mka1ugin/kessy_handles_adapter/schematic.png

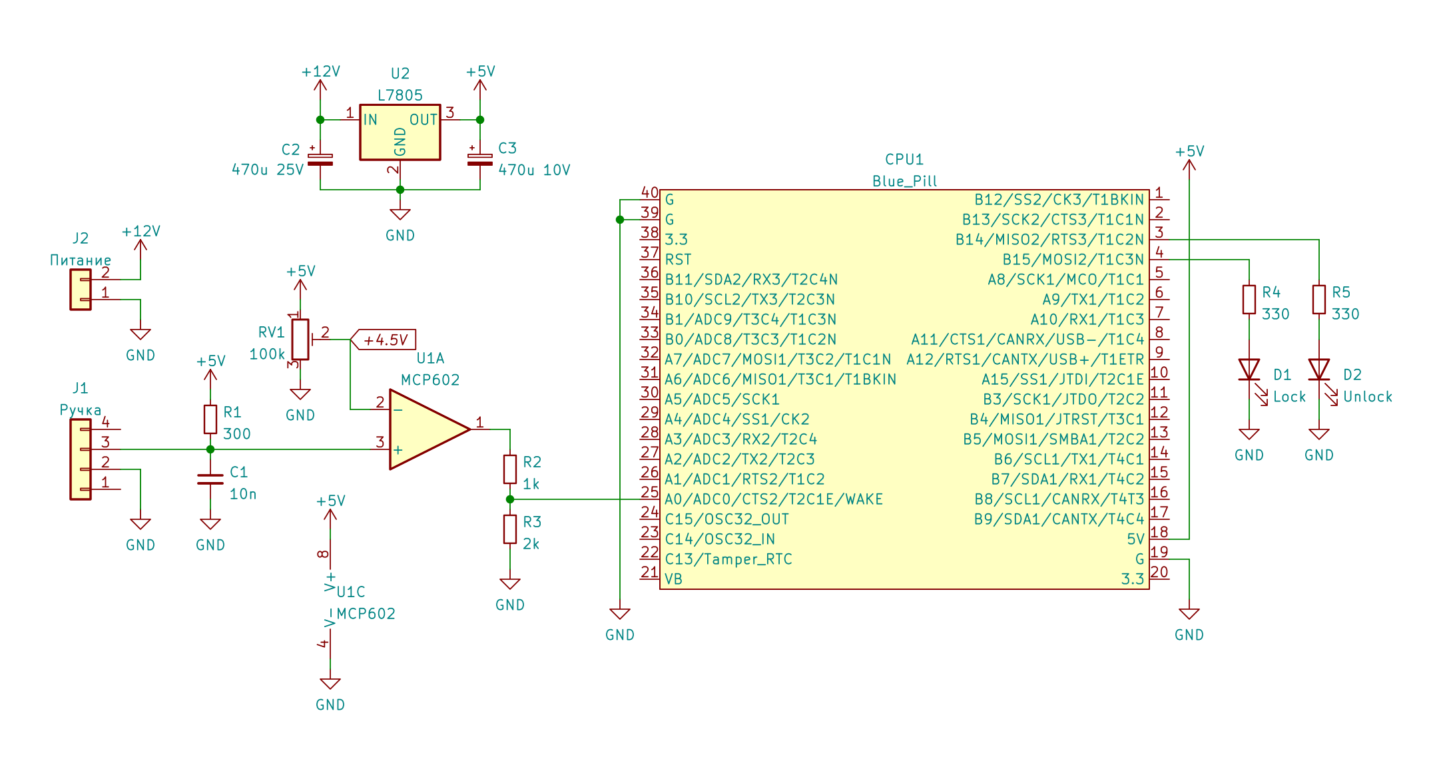
schematic.png
