mka1ugin/kessy_handles_adapter/schematic.pdf

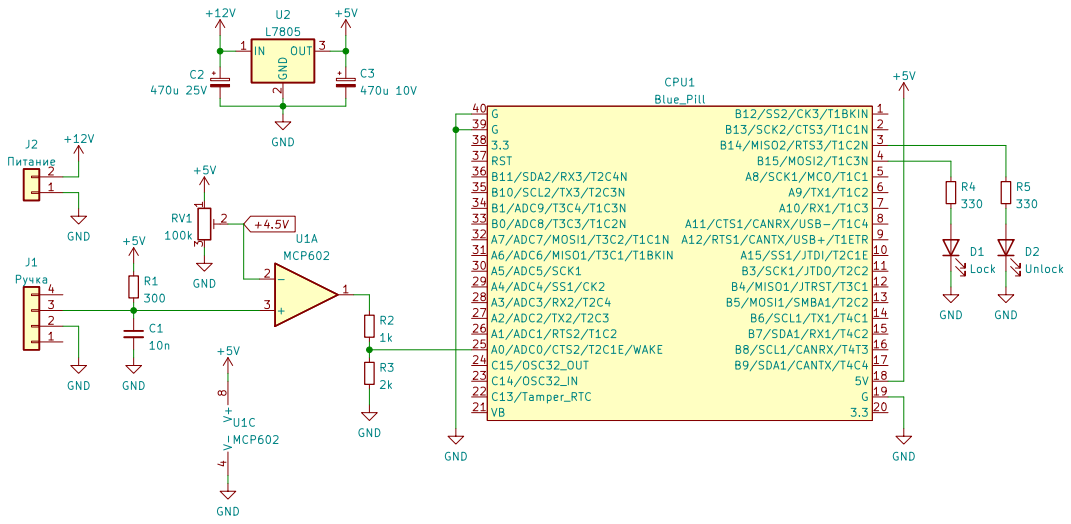
[picture p2: page 1]

File: sample.kicad_sch Sheet: / GND
