mka1ugin/kessy_handles_adapter/Core/Src/main.c

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
/* Includes ------------------------------------------------------------------*/
#include "main.h"

TIM_HandleTypeDef htim2;
TIM_HandleTypeDef htim3;

void SystemClock_Config(void);
static void MX_GPIO_Init(void);
static void MX_TIM2_Init(void);
static void MX_TIM3_Init(void);
/* USER CODE BEGIN PFP */
uint32_t period = 0;
uint32_t pulseWidth = 0;
/* USER CODE END PFP */

/**
  * @brief  The application entry point.
  * @retval int
  */
int main(void)
{
  /* MCU Configuration--------------------------------------------------------*/

  /* Reset of all peripherals, Initializes the Flash interface and the Systick. */
  HAL_Init();

  /* Configure the system clock */
  SystemClock_Config();

  /* Initialize all configured peripherals */
  MX_GPIO_Init();
  MX_TIM2_Init();
  MX_TIM3_Init();
  /* USER CODE BEGIN 2 */
  HAL_TIM_IC_Start_IT(&htim2, TIM_CHANNEL_1);
  HAL_TIM_IC_Start_IT(&htim2, TIM_CHANNEL_2);
	HAL_TIM_Base_Start_IT(&htim3);
  /* USER CODE END 2 */

  /* Infinite loop */
  /* USER CODE BEGIN WHILE */
  while (1)
  {		
    /* USER CODE END WHILE */

    /* USER CODE BEGIN 3 */
  }
  /* USER CODE END 3 */
}

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
/* USER CODE BEGIN 4 */
void HAL_TIM_IC_CaptureCallback(TIM_HandleTypeDef *htim)
{
  if (htim->Instance == TIM2)
  {
    if(htim->Channel == HAL_TIM_ACTIVE_CHANNEL_1)
    {
      period = HAL_TIM_ReadCapturedValue(&htim2, TIM_CHANNEL_1);
      pulseWidth = HAL_TIM_ReadCapturedValue(&htim2, TIM_CHANNEL_2);
      
      TIM2->CNT = 0;
			
			if (pulseWidth >= (Lock_Pulse_Width_ms - Tolerance_ms) * 100 && 
				pulseWidth <= (Lock_Pulse_Width_ms + Tolerance_ms) * 100 &&
				(period - pulseWidth) >= (Pause_width_ms - Tolerance_ms) * 100 && 
				(period - pulseWidth) <= (Pause_width_ms + Tolerance_ms) * 100)
		{
			HAL_GPIO_WritePin(Lock_GPIO_Port, Lock_Pin, GPIO_PIN_SET);
			TIM3->CNT = 0;
		}
		
		if (pulseWidth >= (Unlock_Pulse_Width_ms - Tolerance_ms) * 100 && 
				pulseWidth <= (Unlock_Pulse_Width_ms + Tolerance_ms) * 100 &&
				(period - pulseWidth) >= (Pause_width_ms - Tolerance_ms) * 100 && 
				(period - pulseWidth) <= (Pause_width_ms + Tolerance_ms) * 100)
		{
			HAL_GPIO_WritePin(Unlock_GPIO_Port, Unlock_Pin, GPIO_PIN_SET);
			TIM3->CNT = 0;
		}		
    }
  }
}

void HAL_TIM_PeriodElapsedCallback(TIM_HandleTypeDef *htim)
{
	if (htim->Instance == TIM3)
	{
		HAL_GPIO_WritePin(Unlock_GPIO_Port, Unlock_Pin, GPIO_PIN_RESET);
		HAL_GPIO_WritePin(Lock_GPIO_Port, Lock_Pin, GPIO_PIN_RESET);
	}
}
/* USER CODE END 4 */
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
