mka1ugin/kessy_handles_adapter/Core/Inc/main.h

#define Unlock_Pin GPIO_PIN_14
#define Unlock_GPIO_Port GPIOB
#define Lock_Pin GPIO_PIN_15
#define Lock_GPIO_Port GPIOB
#define Lock_Pulse_Width_ms					41
#define Unlock_Pulse_Width_ms 			8
#define Pause_width_ms							10
#define Tolerance_ms								2
